Donk970/TechnoTomato/Documentation/Images/Leaf Sensor Output.png

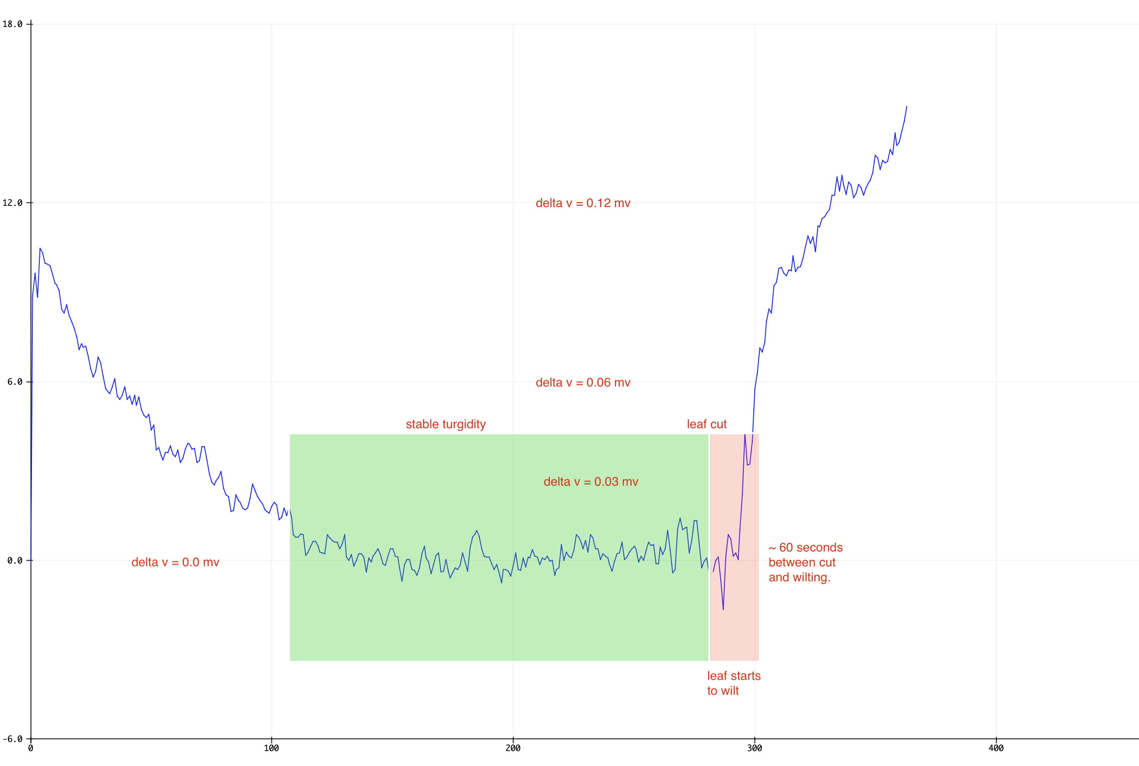
Documentation/Images/Leaf Sensor Output.png
