Donk970/TechnoTomato/Documentation/Images/NewSprayAlignmentTube.png

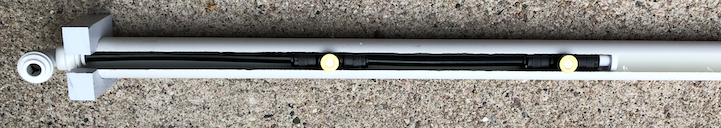
Documentation/Images/NewSprayAlignmentTube.png
