Donk970/TechnoTomato/Documentation/Images/NewSprayNozzle.png

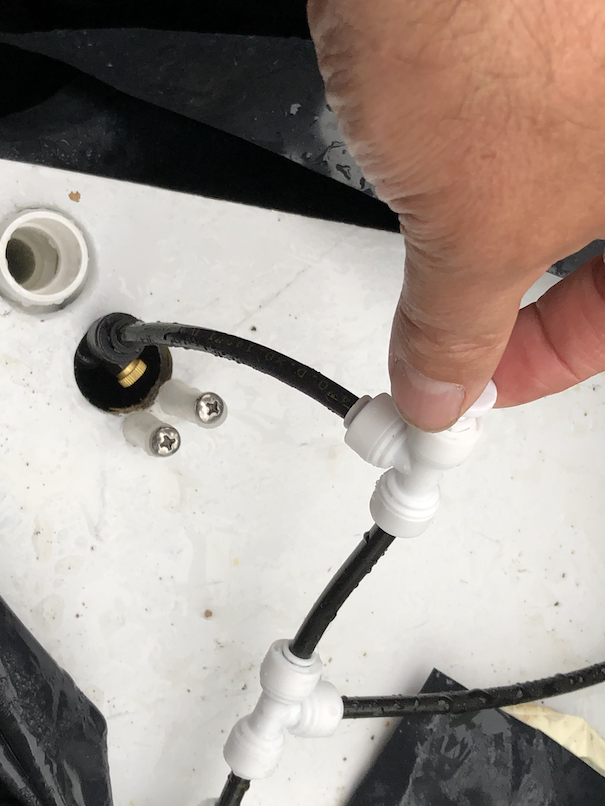
Documentation/Images/NewSprayNozzle.png
