Donk970/TechnoTomato/Documentation/Images/NewSprayNozzleInPlace.png

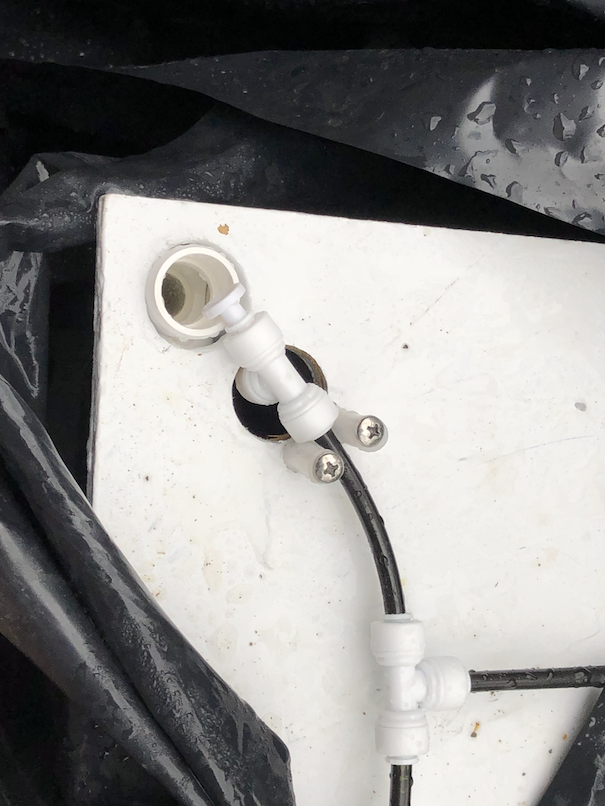
Documentation/Images/NewSprayNozzleInPlace.png
