Donk970/TechnoTomato/Documentation/Images/PlantSupportFrame.png

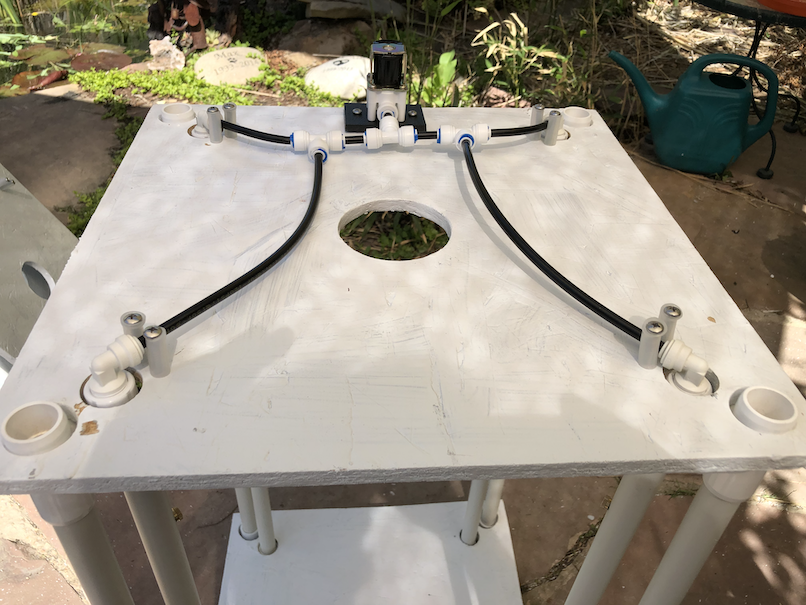
Documentation/Images/PlantSupportFrame.png
