Donk970/TechnoTomato/Documentation/Images/Plumbing/SolenoidValve.png

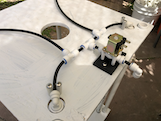
Documentation/Images/Plumbing/SolenoidValve.png
