Donk970/TechnoTomato/Documentation/Images/Produce/Tomatoes.png

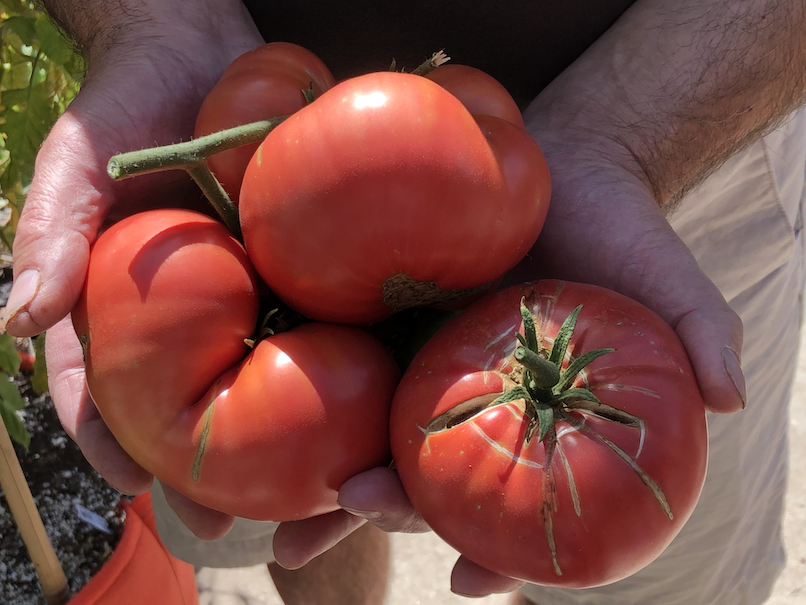
Documentation/Images/Produce/Tomatoes.png
