Donk970/TechnoTomato/Documentation/Diagrams/SumOfDiffs aproximately zero.pdf

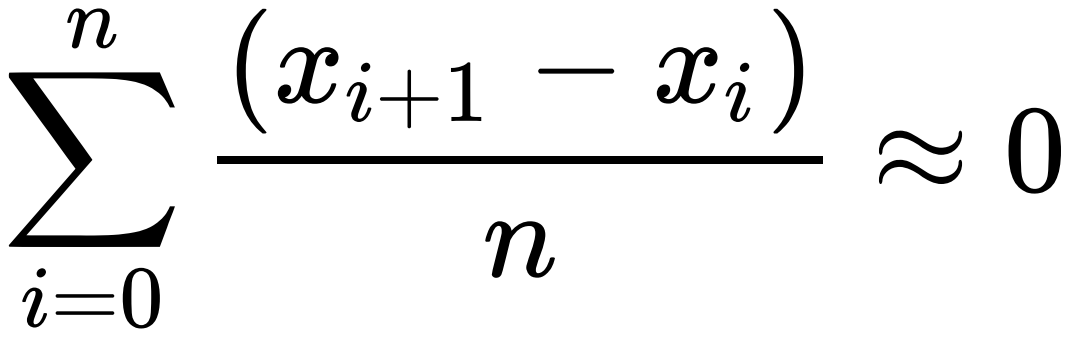
[picture p27: page 1]
