Donk970/TechnoTomato/Documentation/Diagrams/SumOfDiffs greater than zero.pdf

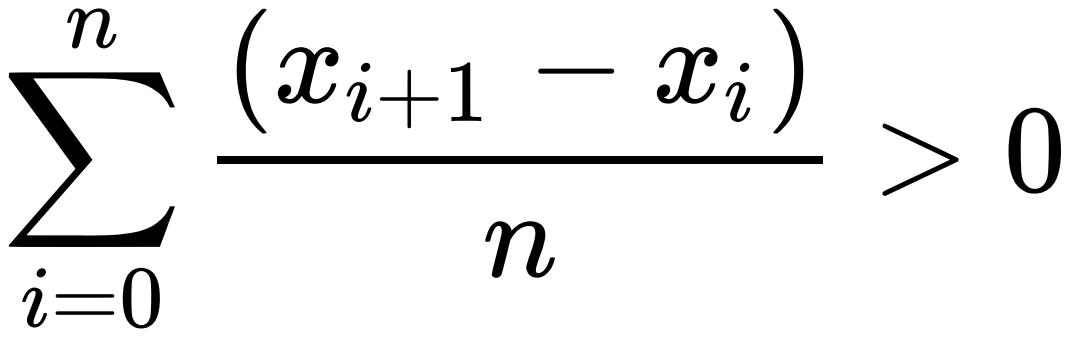
[picture p28: page 1]
