Donk970/TechnoTomato/(threads)

Thread 1 (2019-08-12):

Change View X Axis drawing to time based.

Donk970, 2019-08-12:
The viewers x-axis is simple sample based which works most of the time but if there are gaps in the data you get a really compressed time scale.  The x-axis should compute x location of sample based on sample time rather than index.
