Donk970/TechnoTomato/(commit log)

2019-07-16 converted pressure pump image to jpeg
2019-07-16 resized a couple of the larger images
